ssmontano/Final_Project_IMT231/Proteus/Esquematico.PDF

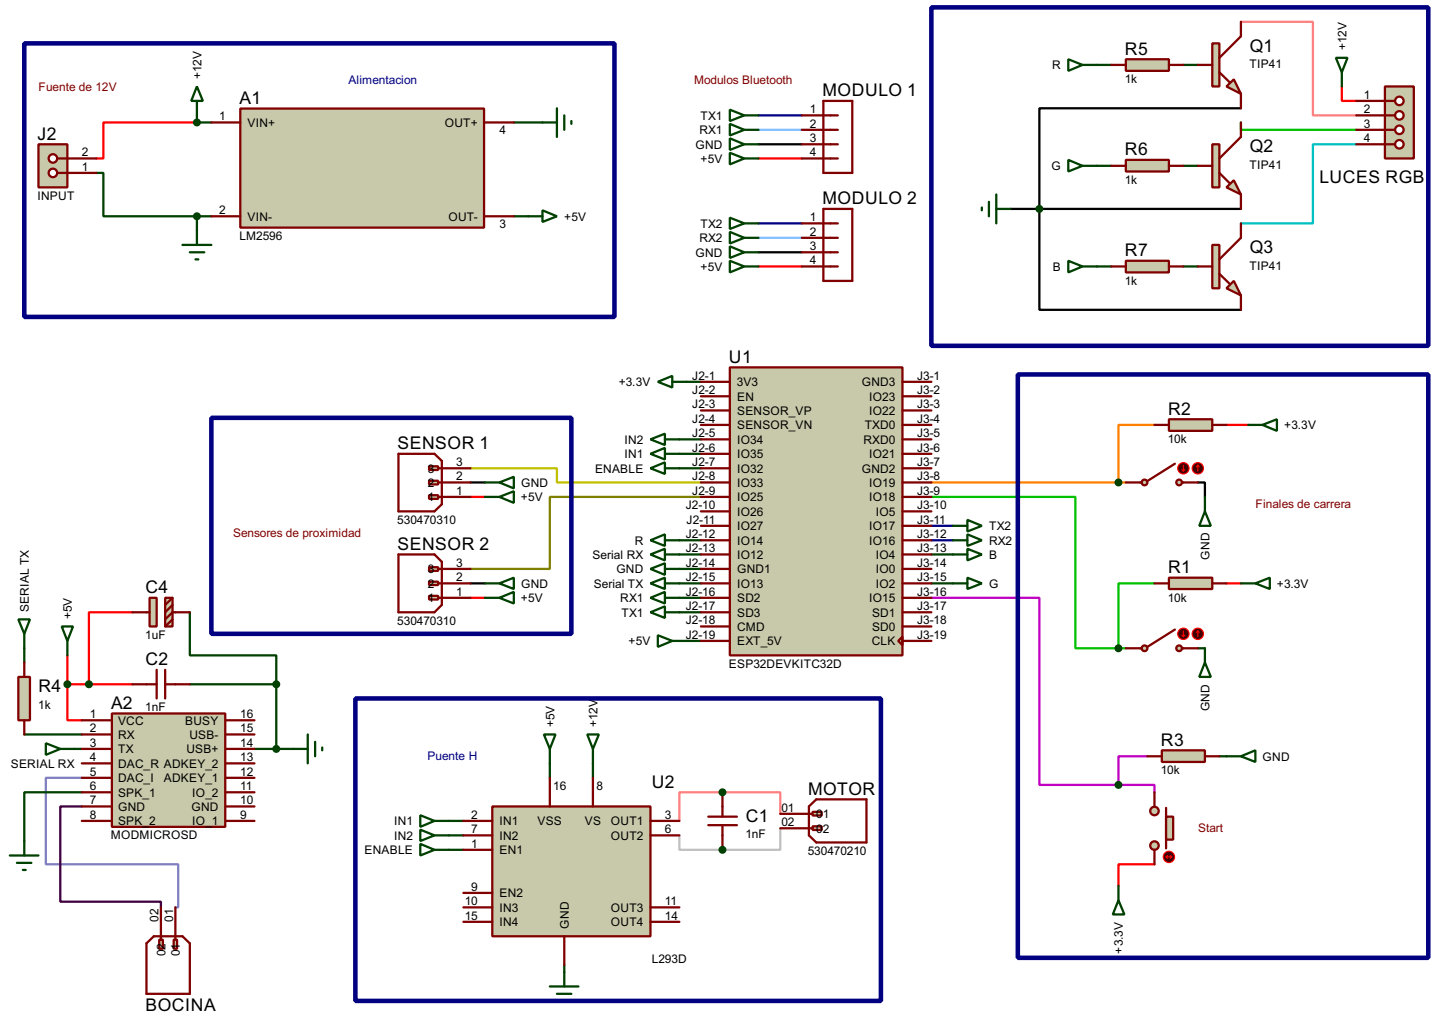
[picture p6: page 1]
