ssmontano/Final_Project_IMT231/(list of files, drawings)

Other design files:
Proteus/nuevodiseñoestadio.pdsprj
